eanopolsky/drive-bay-blank/drive bay blank.scad

/*
3.5" Drive Bay Blank
(C) 2016 Eric Anopolsky

All dimensions are in mm.
TODO: Alter dimensions to compensate for shrinkage.
*/

/* Dimensional accuracy.
 * When printed using PLA on a RepRap Prusa i3 from HIC, width 
 * was set to 101.60 and height was set to 25. Actual width was 101.20
 * and actual height was 25.06. The blank fit into the bay acceptably.
 * 
 * However, M3 nuts did not fit into the cutouts. Width across corners 
 * for the cutouts was set to 6. Actual width across corners was around 5.
 *
 * Screw holes were also slightly too small. They were set to 3.30, but
 * were actually around 3.0 in the printed part. This caused very minor
 * binding on screw insertion, but not enough to justify changing the
 * parameter at this time.
 */

//Revision information:
revYear="2016";
revMonthDayOther="0220A";

//variables for part without holes
thickness=5; //thickness of the walls of the blank
depth=85+30+10; //depth of the blank into the PC case. 147mm per spec, but we can get away with less.
width=101.60; //width of the front of the blank
height=25; //height of the front of the blank

//variables for screw cutouts
screwHoleCenterHeight=4.5; //distance between the center of each screw hole and the bottom of the part.
/* Per http://www.metrication.com/engineering/fastener.html
 * the width across corners of a metrix hex nut is twice the
 * basic screw diameter.
 * hexNutWidth contains this "width across corners" measurement. With
 * 0.4mm layer thickness, a value of 7mm here was necessary to
 * accommodate the nut. However, with 0.2mm layer thickness, a gap of
 * .1mm around the outside of the nut may be adequate (and is
 * recommended on various sites for a press fit.
 */
hexNutWidth=6+.2;
hexNutHeight=2.4; //This parameter is not currently used. Spec is 2.15mm<height<2.4mm
M3ScrewClearance=3.30;
interiorHeight=screwHoleCenterHeight+(hexNutWidth/2*sin(60))*2+thickness; //distance between the top and bottom of the part inside the PC case

module partWithoutHoles() {
    union() {
    intersection() { 
        linear_extrude(height) polygon([[0,0],[0,depth],[thickness,depth],[thickness,thickness],[width-thickness,thickness],[width-thickness,depth],[width,depth],[width,0]]); //Main part body.
        rotate([0,-90,0]) translate([0,0,-width]) linear_extrude(height=width) polygon([[0,0],[0,depth],[       interiorHeight,depth],[interiorHeight,thickness+height-interiorHeight],[height,thickness],[height,0]]); //Trims interior height to optimize build time.
    }
    translate([0,thickness,0])
    linear_extrude(thickness) { //Gussets
        polygon([[0,0],[0,width/2],[width/2,0]]);
    }
    translate([0,thickness,0])
    linear_extrude(thickness) { //Gussets
        polygon([[width,0],[width/2,0],[width,width/2]]);
    }
    }
}

module screwNutCutout() {
//rotate([0,0,360/12]) //Rotating the nut cutout is perhaps unhelpful due to overhang. 
union() {
    //This produces a simple hex shape, resulting in 30 degree overhangs.
    //translate([0,0,-1]) linear_extrude(height=hexNutHeight+1) circle(hexNutWidth/2,$fn=6);
    
    
    //Height for the extrusion is set to thickness-1.5 so M3 screws with 5mm lengths will
    //be able to reach the hex nut. The +1 along with the translation by -1 on the z axis
    //prevent rendering errors in openscad.
    translate([0,0,-1]) linear_extrude(height=(thickness-1.5)+1)
    union() {
        circle(hexNutWidth/2,$fn=6);
        //This produces a hex shape with a modified side to allow for 60 degree overhangs.
        polygon([[hexNutWidth/2*cos(60),hexNutWidth/2*sin(60)],[0,2*hexNutWidth/2*sin(60)],[-hexNutWidth/2*cos(60),hexNutWidth/2*sin(60)]]);
      }
    //The hole for the M3 screw:
    linear_extrude(height=thickness+1)
    union() {
        circle(M3ScrewClearance/2,$fn=40);
        //This polygon() prevents drooping on the M3 screw clearance due to overhangs.
        polygon([[-M3ScrewClearance/2*cos(30),M3ScrewClearance/2*sin(30)],[0,M3ScrewClearance/2*sqrt(3)],[M3ScrewClearance/2*cos(30),M3ScrewClearance/2*sin(30)]]);
    }
}
}

module partWithHoles() {
difference() {
    partWithoutHoles();
    translate([thickness,85,screwHoleCenterHeight]) rotate([90,0,-90]) screwNutCutout();
    translate([thickness,85+30,screwHoleCenterHeight]) rotate([90,0,-90]) screwNutCutout();
    translate([width-thickness,85,screwHoleCenterHeight]) rotate([90,0,90]) screwNutCutout();
    translate([width-thickness,85+30,screwHoleCenterHeight]) rotate([90,0,90]) screwNutCutout();
}
}

module versionedPart() {
    difference() {
        partWithHoles();
        translate([1.3*thickness,1.3*thickness,thickness-1])
        linear_extrude(height=3)
        union() {
            translate([0,10,0]) text(text=revYear,size=8,font="Arial:style=Bold");
            text(text=revMonthDayOther,size=8,font="Arial:style=Bold");
        }
    }
}

module partWithPowerButtonHole() {
    difference() {
        versionedPart();
        
        translate([width/2,0,thickness+8+2])
        rotate([90,0,0])
        translate([0,0,-(thickness+1)])
        linear_extrude(height=thickness+2)
        union() {
            circle(r=8,$fn=40);
            //rotate([0,0,45]) square([8,8]);
            translate([-8,0]) square([16,50]);
        }
    }
}

partWithPowerButtonHole();

//One copy:
//versionedPart();

//Two copies:
/*
versionedPart();
translate([width+width/2,depth+3*thickness,0])
rotate([0,0,180]) versionedPart(); 
*/

//Three copies:
/*
translate([0,width,0]) rotate([0,0,-90]) versionedPart();
translate([0,width*2+thickness,0]) rotate([0,0,-90]) versionedPart();
translate([depth+thickness*4,width/2,0]) rotate([0,0,90]) versionedPart();
*/

//Four copies:
/*
translate([0,width,0]) rotate([0,0,-90]) versionedPart();
translate([0,width*2+thickness,0]) rotate([0,0,-90]) versionedPart();
translate([depth+thickness*4,width/2,0]) rotate([0,0,90]) versionedPart;
translate([depth+thickness*4,width+thickness+width/2,0]) rotate([0,0,90]) versionedPart();
*/

//Prusa i3 build area.
//color("blue") square([200,200]);
