eanopolsky/drive-bay-blank/(commit log)

2016-02-14 initial project version
    [drive bay blank.scad]
2016-02-14 adjustments for print discrepancies, presets for multiple copies
    [drive bay blank.scad]
2016-02-14 removed TODO lines for completed tasks
    [drive bay blank.scad]
2016-02-14 quick hack to determine nut cutout thickness and width experimentally
    [nutslot.scad]
2016-02-17 Fixed comment.
    [drive bay blank.scad]
2016-02-17 Enlarged gussets.
    [drive bay blank.scad]
2016-02-17 Fixed rendering error.
    [drive bay blank.scad]
2016-02-18 Fixed cutouts for screws and nuts.
    Added version mark for easier printed part identification.
    Fixed hex nut cutout depth so 5mm screws could reach nuts.
    Corrected hex nut height parameter to M3 spec. This parameter is not
    currently used, but could be used if the design were changed so nuts
    could be dropped into a vertical slot.
    Added triangle to screw hole shape to fix overhang issues.
    [drive bay blank.scad]
2016-02-18 Reduced version text cutout depth.
    Adding version text in the last commit increased print time from around 1h 15m to 1h 45m. Decreasing the depth of the cutout may decrease print time.
    [drive bay blank.scad]
2016-02-19 Added hole for power button.
    Accommodates a 16mm momentary contact switch.
    [drive bay blank.scad]
2016-02-21 Testing smaller nut cutout.
    This may be necessary for a press fit with a 0.2mm layer thickness using a
    0.5mm nozzle.
    [drive bay blank.scad]
